earnaud/KOSMOS_test/docs/index.rst

Guide d'assemblage
==========

Cette œuvre est mise à disposition selon les termes de la `Licence
Creative Commons Attribution - Pas d’Utilisation Commerciale - Partage
dans les Mêmes Conditions 4.0
International. <https://creativecommons.org/licenses/by-nc-sa/4.0/>`__
L’auteur à mentionner est Konk Ar Lab et Ifremer

Le KOSMOS est un système pensé collectivement pour prendre la suite des
STAVIRO et MICADO. Deux systèmes développées par Ifremer pour
l’évaluation de l’état des habitats côtiers comme le dénombrement des
éspéces de poissons. Ce système a fait l’objet d’une publication dans la
revue sensors. `Cliquez sur ce lien pour consulter l’article en libre
accès. <https://www.mdpi.com/1424-8220/21/22/7724>`__

Depuis 2011, ces systèmes ont été perfectionnés et une méthodologie
complète qui va de la collecte au traitement des images a été mise au
point (Pelletier et al., 2016). Cette technique est déjà adoptée par le
Parc Naturel Marin de Mayotte, et pourrait convenir aux besoins de suivi
et d’évaluation de la Directive Cadre sur le Milieu Marin qui impose
d’évaluer le bon état écologique des mers européennes, ainsi qu’aux
besoins d’autres Aires Marines Protégées.

Ifremer s’est donc tourné vers le FabLab de Concarneau en sa qualité de
lieu de facilitation sociale par le numérique. Konk Ar Lab, implanté sur
le territoire de Concarneau Cornouaille Agglomération (CCA), il fait
figure depuis presque trois ans d’un lieu de choix réunissant tout type
de publics locaux autour de projets numériques et techniques venus de
divers horizons. C’est dans l’axe Océan du FabLab, que vient se placer
le projet proposé par Ifremer. Il deviendra alors un moyen innovant
d’aborder l’océan et faire connaître ses métiers auprès du public, du
territoire.

Ainsi Ifremer s’est associé au FabLab, pour concevoir un système inspiré
du STAVIRO et du MICADO avec la volonté de l’ouvrir à tous en
documentant sa conception. Ce projet technique sera donc un support pour
l’oeuvre sociale que mène le FabLab. A plus long terme, et ce avec
probablement le fonds Explore1 et le Marinarium2 de Concarneau, le
système pourrait alimenter un nouveau programme de sciences
participatives afin d’élargir l’audience de la sensibilisation à
l’environnement par la contribution directe du grand-public à la
recherche océanographique.

A/ Matériel nécessaire
----------------------

-  Imprimante 3D (plateau 20*20 minimum)
-  Fer à souder
-  Ecran avec connecteur HDMI
-  Souris USB
-  Clavier
-  Pince à sertir les connecteurs dupont
-  Troisième main
-  Gaine thermorétractable
-  Fil d’étain
-  Tourne vis
-  clés plates
-  Mini-perceuse-fraiseuse Dremel avec ses mini-fraises
-  Scotch papier (Protection des circuits électroniques pendant fraisage
   des trous de la PiCam)
-  Chargeur de baterrie lipo 3s
-  Câble HDMi - micro HDMi
-  Alimentation secteur Raspberry pi 4 (Usb C)
-  Coupe tube
-  scie à méteaux
-  pied à coulisse
-  réglet
-  `Pro-tronik Prog
   ; <https://www.absolu-modelisme.com/pro-tronik-03878035-bf32-usb-prog.html?___SID=U>`__

B/ Fournitures nécessaires
--------------------------

**Par KOSMOS 3.0**

-  `1 Raspberry Pi 4 modèle B 2Go de ram
   minimum <https://www.kubii.fr/cartes-raspberry-pi/2771-nouveau-raspberry-pi-4-modele-b-2gb-0765756931175.html>`__
   ;
-  `1 Carte Micro SD avec son adaptateur SD vitesse d’encodage 10 et
   capacité 32Go minimum
   ; <https://www.kubii.fr/carte-sd-et-stockage/1819-carte-microsd-kingston-32gb.html?search_query=sd&results=116>`__
-  `1 Clé USB à très faible encombrement
   ; <https://fr.rs-online.com/web/p/cles-usb/7869326>`__
-  `1 Pi camera HQ
   ; <https://www.kubii.fr/cameras-capteurs/2950-camera-hq-officielle-633696492738.html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>`__
-  1 `Objectif Aico 4mm de
   focale <https://aico-lens.com/product/manual-iris-4-0mm-2mp-f2-c-mount-industrial-lens-ach0420mm/>`__
   ;
-  `1 Batterie Li-Po 3s (3 cellules, 2200 mAh) de dimensions maximales
   35X25X115 (en mm)
   ; <https://www.absolu-modelisme.com/accu-lipo-3s-11-1v-2200mah-45c-xt60.html?___SID=U>`__
-  `1 Contrôleur de moteur Brushless ESC 25A pour batterie 3S avec BEC à
   5v et 2A minimum
   ; <https://www.absolu-modelisme.com/pro-tronik-esc-bf30a-bec-3a.html?___SID=U>`__
-  `1 Moteur Brushless immergeable (F 2838 ou équivalent Blue Robotics)
   ; <https://www.amazon.fr/Dilwe-Moteur-imperm%C3%A9able-Brushless-Outrunner/dp/B07PFJD1MQ>`__
-  `2 Bobines de 750g de filament PETG
   ; <https://www.arianeplast.com/218-3d-filament-petg>`__
-  1 Kit de connecteurs dupont ;
-  `4 Résistances 1 Kohm
   ; <https://fr.rs-online.com/web/p/resistances-traversantes/4777928>`__
-  `2 Résistances 220 ohm
   ; <https://fr.rs-online.com/web/p/resistances-traversantes/7397405>`__
-  `1 LED verte ; <https://fr.rs-online.com/web/p/led/0826436>`__
-  `1 LED rouge ; <https://fr.rs-online.com/web/p/led/2285988>`__
-  `2 ILS (Interrupteur à lame souple)
   ; <https://fr.rs-online.com/web/p/interrupteurs-reed/1718465>`__
-  `1 Rallonge de câble de charge batterie 3s
   ; <https://www.absolu-modelisme.com/rallonge-lipo-30cm-22awg-jst-hx-3s.html?___SID=U>`__
-  Colsons fins (2mm) de longueur 160 mm ;
-  Graisse silicone (matériel de plongée) ;
-  `1 Carte de prototypage en ligne
   ; <https://fr.rs-online.com/web/p/cartes-a-bandes/1004328>`__
-  `1 Connecteur XT60 male
   ; <https://www.absolu-modelisme.com/prise-xt60-male.html?___SID=U>`__
-  `1 Boite d’entretoise laiton
   M2,5 <https://www.amazon.fr/gp/product/B07MN2GY6Y/ref=ppx_yo_dt_b_asin_title_o01_s00?ie=UTF8&psc=1>`__
-  `1 Boite de visserie Inox
   M2,5 <https://www.amazon.fr/gp/product/B07RBTGT7B/ref=ppx_yo_dt_b_asin_title_o01_s00?ie=UTF8&psc=1>`__

Visserie Inox A4

-  8 Vis M3 20mm (pour la fixation de la Raspberry et de la Pi camera)
-  120 Ecrous M3
-  Tige filetée M8 (120mm)

Matériel `Blue Robotics <https://bluerobotics.com/>`__

-  `1 Tube acrylique 298 mm (4" series
   ) <https://boutique.rov-expert.fr/blue-robotics/28-19-tube-acrylique.html#/16-declinaison-4_298mm>`__
   ;
-  1 Pompe à vide manuelle
-  `1 Capteur de pression Bar 30
   ; <https://boutique.rov-expert.fr/blue-robotics/8-bar30-capteur-de-pression-haute-resolution-300m.html>`__
-  `1 Bouton de commande étanche
   ; <https://boutique.rov-expert.fr/blue-robotics/101-Interrupteur.html>`__
-  `1 Tape (End cap) Aluminium 5 trous (4" series)
   ; <https://boutique.rov-expert.fr/blue-robotics/4-6-tape-aluminium.html#/6-declinaison-5_trous_4_>`__
-  `1 Tape (End cap) Acrylique (4"series)
   ; <https://boutique.rov-expert.fr/blue-robotics/30-22-tape-acrylique-transparente.html#/1-declinaison-serie_3_>`__
-  `1 Bouchon de purge (Vent)
   ; <https://boutique.rov-expert.fr/blue-robotics/38-aeration-et-bouchon.html>`__
-  `2 connecteurs 3 broches cobalt
   ; <https://boutique.rov-expert.fr/blue-trail-engineering/140-132-connecteur-de-cloison-cobalt-m10.html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>`__
-  `2 câbles 3 broches cobalt
   ; <https://boutique.rov-expert.fr/blue-trail-engineering/141-136-connecteur-cobalt.html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>`__
-  Résine pour pénétrateur ;

1/ Impression des pièces en 3D
------------------------------

Imprimer toutes les pièces nécessaires. `Les fichiers STL sont
disponibles
ici <https://wikifactory.com/@konkarlab/kosmos30/files/KOSMOS_3-0_beta1/3Dmodels_KOSMOS_3-0>`__
.

**1.1 Pour l’intérieur du caisson :**

-  1 x I1 qui va supporter la carte Rapsberry
-  1x I2, qui va faire le lien entre la structure Raspberry et la plaque
   sur laquelle va se positionner les batteries.
-  1x I3,qui va supporter la PiCam
-  1x I4, qui va se visser à une flange du tube pour empécher les
   structures internes du KOSMOS de pouvoir tourner dans le tube.

`View inte3D_legende.png @
Wikifactory <https://wikifactory.com/@konkarlab/kosmos30/file/pictures_assembly_process/Captions/inte3D_legende.png>`__

**1.2 Pour l’extérieur du caisson :**

Toutes ces pièces doivent êtres impérativement imprimés en PET. En
effet, cette matière est la plus résistante à l’eau de mer parmi les
matériaux disponibles en impression 3D FDM. Si vous disposez d’autres
technologies, ne pas hésiter à essayer et nous faire part du résultat.
Cependant, nous savons que la résine par SLA ne convient pas pour une
raison de dureté. Il peut-être intéressant également de travailler à un
réducteur sans impression 3D à la fraiseuse uniquement pour rendre la
plongée possible à de plus grandes profondeurs.

Nous recommandons un taux de remplissage des pièces qui ne soit
inférieur à 30%. Toutes nos pièces ont un taux de remplissage à 100%.

-  1x R3 qui permet de transmettre l’effort de la croix de malte à la
   tige fileté.
-  1x R5, permets de guider l’arbre secondaire et de ne pas serrer les
   flasques avec les engrenages de cet arbre.
-  1x R6, une entretoise sur l’arbre primaire
-  1x R4, l’entretoise pour le support moteur
-  1x Reducteur3D n°5 SupMag, permets de placer le capteur magnétique
-  2x R1 et 2x R1.2 , permet de maintenir le caisson solidaire au

`View PHOTO_20220317_182010_petit.png @
Wikifactory <https://wikifactory.com/@konkarlab/kosmos30/file/pictures_assembly_process/Captions/PHOTO_20220317_182010_petit.png>`__

*Note : Toutes les pièces devront être netoyées de leurs supports et au
cours du montage, elles nécéssiteront peut-être d’être limées (papier de
verre ou lime à main) afin de supprimer toutes traces de fils d’anges.*

2/ Découpe des pièces planes au laser
-------------------------------------

Le KOSMOS 2.3 est composé en plus de pièces imprimés en 3D et de
visserie Inox de pièces à découper au laser dans des plaques de PMMA et
de POM. Ainsi on peut immerger ses pièces dans l’eau sans craindre la
pression. Les pièces de l’intérieur du caisson peuvent être aussi
imprimés en 3D. `Les trois fichiers vectoriels évoqués ci-dessous sont
disponibles
ici. <https://wikifactory.com/@konkarlab/kosmos30/files/KOSMOS_3-0_beta1/Laser-cuts_KOSMOS_3-0_beta1>`__

**2.1 Pour l’intérieur du caisson :**

-  Télécharger le fichier PMMA-5mm_A5_laser-cut.svg
-  Découper les pièces S1 S2 dans du PMMA de 5mm d’éppaisseur (prévoir
   l’équivalent de la surface d’une feuille A5) ;

`View legende_str_int_PMMA_5mm_A5.png @
Wikifactory <https://wikifactory.com/@konkarlab/kosmos30/file/pictures_assembly_process/Captions/legende_str_int_PMMA_5mm_A5.png>`__

**2.2 Pour l’extérieur du caisson :**

Ces pièces constituent l’enveloppe du réducteur du KOSMOS. On peut les
réaliser en PMMA 5mm si on veut voir à travers ou un autre plastique de
5mm comme des plaques de plastique recyclé.

-  Il est nécéssaire de sélectionner une plaque de PMMA bien plane de
   5mm d’épaisseur (prévoir l’équivalent de la surface d’une feuille A3)
   ;
-  Télécharger le fichier PMMA-5mm_A3_Laser-cut.svg pour lancer une
   découpe au laser ou à la fraiseuse numérique ;
-  Toutes les pièces sont disposées ici de manière à rentrer dans un
   format A3 (42*29,7 cm).

`View legende_decoupePMMAA3.png @
Wikifactory <https://wikifactory.com/@konkarlab/kosmos30/file/pictures_assembly_process/Captions/legende_decoupePMMAA3.png>`__

**2.3 Les pièces en mouvements (engrenages…) seront usinés de préférence
en POM.**

-  Il est nécéssaire de sélectionner une plaque de POM bien plane de 5mm
   d’épaisseur ;
-  Utiliser le fichier POM-5mm_A4_laser-cut.svg pour lancer une découpe
   ;
-  Toutes les pièces sont disposées ici de manière à rentrer dans un
   format A4 (21*29,7 cm) ;

`View legende_decoupePOMA4.png @
Wikifactory <https://wikifactory.com/@konkarlab/kosmos30/file/pictures_assembly_process/Captions/legende_decoupePOMA4.png>`__

3/ Assemblage des composants intérieurs au caisson
--------------------------------------------------

3.1 **Assemblage de la caméra :**

-  Rassembler, la Picam HQ, sa nappe (câble plat), la stucture caméra
   n°3, 3 vis M2,5*5mm, 4 entretoises en laiton M2,5*5+5mm et 4
   rondelles M2,5.



   image

-  A l’aide d’une pince plate, visser les 4 entretoises en laiton dans
   les trous prévus à cet effet dans la structure de la caméra n°3.



   image

-  Puis, à l’aide d’une clé alen de 2mm, visser la caméra sur ses 4
   entretoises à l’aides des 4 vis M2,5 et 4 rondelles. La caméra doit
   être positionné comme présenté sur la photo ci dessous. La sortie de
   la nappe du coté opposé aux fixations.



   image

**3.2 Assemblage de la Raspberry :**

-  Rassembler, le support de la Raspberry, structure n°6, la Raspberry
   Pi 4 modèle B, 4 entretoises en laiton M2,5*10, 4 vis M2,5 6mm et 4
   rondelles M2,5.



   image

-  A l’aide d’une pince plate, visser les 4 entretoises sur les trous
   R1, R2, R3 et R4 (cf photo ci dessous).



   image

-  Enfin, à l’aide d’une clé alen 2mm, visser la raspberry sur son
   support (cf photo ci-dessous). Veiller au sens, l’encode de la
   structure 6 doit être en face de l’emplacement de la carte SD de la
   Raspberry.



   image

**3.3 Assembler le circuit d’alimentation :**

-  Rassembler, le circuit d’alimentation (cf etape Câblage), la
   Raspberry sur son support, 2 entretoises laiton de 5mm, 2 vis M3*5mm,
   2 vis M2,5*5mm et 2 rondelles.



   image

-  A l’aide d’une pince plate, visser les deux entretoises sur deux
   trous diagonalement opposés au dos de la Raspberry sur le pièce en
   PMMA. (Si vous possédez plus d’entretoise que nous, n’hésitez pas à
   en disposer 4).
-  Visser avec les deux vis M3 le transformateur 12 to 5v et le relai
   sur les entretoises à l’aide des vis M2,5.



   image

-  Passer le câble avec le connecteur USB-C par l’encoche de la
   structure n°6 de manière à pouvoir le brancher sur le port
   d’alimentation de la Raspberry. Positionner l’ESC sur le dessus du
   transformateur au moyen d’un scotdh double face. Maintenez les câbles
   à l’aide de colsons.



   image

**3.4 Finalisation de l’assemblage interne :**

-  Rassembler la Raspberry et son support (Str n°6), la caméra et sa
   structue n°3, la structure n°1, N°2 et n°5, 8 ecrous M3, 6 vis
   M3*10mm, et 2 vis M3*15mm, 2 vis M4*30mm, 2 écrous M4.



   image

-  Insérer 4 écrous M3 dans les fentes prévus à cet éffet sur la
   structure n°1 (cf photo ci dessous)



   image

-  Visser la carte Raspberry pi 4 et sonsupport (Str n°6) sur le
   structure n°1 à l’aide de deux vis M3*15mm en haut et deux vis
   M3*10mm en bas. Attention au sens de la Raspberry (cf photo
   ci-dessous).



   image

-  Brancher le connecteur USB-C sur le port d’alimentation de la
   raspberry. Veiller à bien couder la câble afin qu’il ne gène pas à
   l’avenir l’insertion dans le tube.



   image

-  Insérer 2 écrous sur la structure batterie (n°2) et 2 autres sur la
   structure caméra (n°3).
-  Visser la plaque en PMMA (Str n°5) à l’aide de 2 vis M3*10mm sur la
   structure batterie (n°2).



   image

-  Visser l’autre extrémité de la plaque de PMMA (Str n°5) sur la
   structure caméra (n°3).



   image

-  Assembler les deux partie composé l’une de la raspberry et de sa
   structure et de l’autre le support de la batterie et de la caméra.
   Veiller à passer les câbles au travers des pièces et à ne pas les
   abimer.
-  Visser ces deux parties au moyen de deux vis M4*30mm et de deux
   écrous M4. Serrer de manière à ce que la tête de vis ne puisse géner
   l’insertion du KOSMOS dans le Tube.



   image

-  Brancher la nappe de la PiCam à la carte Raspberry. La carte porte
   une inscription “CAMERA” au dessus de ce connecteur , il est à
   proximité des connecteurs USB. Pour la connexion, lever (sans ôter)
   la partie grise du connecteur et placer le côté bleu de l’’extrémité
   de la nappe face aux connecteurs USB. Refermer la pièce de serrage
   grise. (cf photos ci dessous)



   image

**3.5 Installation de la Batterie**

-  Rassembler la partie interne du KOSMOS, une batterie lipo 3s 2200mAh
   une rallonge de câble de recharge Lipo 3s et 2 colsons.



   image

-  Positionner la batterie sur son support sur un des deux flancs.
   Maintenir en place la batterie à l’aide de colsons.



   image

-  Brancher le connecteur XT60 avec celui du circuit d’alimentation.
-  Brancher la rallonge de rechargement au connecteur de la batterie. Ce
   câble circulera vers l’arrière en passant devant la Raspberry.



   image

4/ Assemblage du caisson
------------------------

Pour l’assemblage du tube, il sera nécessaire de graisser (graisse
silicone de plongée) certaines pièces pour à la fois assurer
l’étanchéité et faciliter le démontage du tube étanche. Attention, il ne
faut graisser que les pièces qui coulissent (ex : Flange, bouchons,
interrupteurs rotatifs). Le graissage se fait au doigt et consiste à
simplement huiler les surfaces qui doivent coulisser ou tourner tout en
restant étanche.

**4.1 Assemblage du bouton rotatif :**

-  Le bouton rotatif est livré démonté par Blue robotics. Rassembler le
   passe-coque, le bouton, les trois joints thoriques, le poussoir, les
   deux fils et l’écrou.

`View DSC_0142.JPG @
Wikifactory <https://wikifactory.com/@konkarlab/kosmos30/file/pictures_assembly_process/Camera_case/DSC_0142.JPG>`__

-  Placer le plus grand des trois joint thorique dans la gorge du
   passe-coque.

`View DSC_0147.JPG @
Wikifactory <https://wikifactory.com/@konkarlab/kosmos30/file/pictures_assembly_process/Camera_case/DSC_0147.JPG>`__

-  Au doigt, graisser les deux joints restants. Puis insérer les dans
   les deux gorges du bouton noir.

`View DSC_0149.JPG @
Wikifactory <https://wikifactory.com/@konkarlab/kosmos30/file/pictures_assembly_process/Camera_case/DSC_0149.JPG>`__

-  Visser le bouton noir dans le passe-coque. Le vissage doit être
   facile. Si ce n’est pas le cas, il sera peut-être nécéssaire de
   graisser d’avantage.

`View DSC_0150.JPG @
Wikifactory <https://wikifactory.com/@konkarlab/kosmos30/file/pictures_assembly_process/Camera_case/DSC_0150.JPG>`__

-  Visser l’écrou sur le passe-coque.

`View DSC_0153.JPG @
Wikifactory <https://wikifactory.com/@konkarlab/kosmos30/file/pictures_assembly_process/Camera_case/DSC_0153.JPG>`__

-  A l’extrémité opposé au bouton noir, visser le bouton poussoir.
   Dévisser légèrement le bouton noir de manière à ce que le poussoir
   soit ouvert (surveiller à l’aide d’un multimètre sur le mode
   continuité).
-  Pour finir connecter les fils sur les broches du bouton poussoir.

`View DSC_0163.JPG @
Wikifactory <https://wikifactory.com/@konkarlab/kosmos30/file/pictures_assembly_process/Camera_case/DSC_0163.JPG>`__

**4.2 Assemblage du bouchon vent :**

-  Le bouchon vent est livré démonté par Blue robotics. Rassemblez le
   passe-coque, le bouchon, les trois joints thoriques, le poussoir, les
   deux fils et l’écrou.

`View DSC_0164.JPG @
Wikifactory <https://wikifactory.com/@konkarlab/kosmos30/file/pictures_assembly_process/Camera_case/DSC_0164.JPG>`__

-  Placer le plus grand des trois joint thorique dans la gorge du
   passe-coque. Puis visser l’écrou.

`View DSC_0165.JPG @
Wikifactory <https://wikifactory.com/@konkarlab/kosmos30/file/pictures_assembly_process/Camera_case/DSC_0165.JPG>`__

-  Insérer les deux petits joints thoriques dans les deux gorges du
   bouchon.

`View DSC_0166.JPG @
Wikifactory <https://wikifactory.com/@konkarlab/kosmos30/file/pictures_assembly_process/Camera_case/DSC_0166.JPG>`__

-  Visser le bouchon sur le passe-coque.

`View DSC_0167.JPG @
Wikifactory <https://wikifactory.com/@konkarlab/kosmos30/file/pictures_assembly_process/Camera_case/DSC_0167.JPG>`__

**4.3 Assemblage du capteur de pression**

-  Le capteur de pression est livré démonté par Blue robotics.
   Rassembler le capteur dans son passe-coque, le joint thorique et
   l’écrou.

`View DSC_0168.JPG @
Wikifactory <https://wikifactory.com/@konkarlab/kosmos30/file/pictures_assembly_process/Camera_case/DSC_0168.JPG>`__

-  Insérer le joint thorique dans la gorge et engager l’écrou sur le
   capteur.

`View DSC_0170.JPG @
Wikifactory <https://wikifactory.com/@konkarlab/kosmos30/file/pictures_assembly_process/Camera_case/DSC_0170.JPG>`__

**4.4 Serrage des passes-coques sur le end cap aluminium**

-  Rassembler, le end cap en aluminium à 5 trous, les deux connecteurs
   cobalts femelles, ainsi que les trois passes-coques précédamment
   assemblés (bouton rotatif, bouchon vent, et capteur de pression).

`View DSC_0175.JPG @
Wikifactory <https://wikifactory.com/@konkarlab/kosmos30/file/pictures_assembly_process/Camera_case/DSC_0175.JPG>`__

-  Visser les des connecteurs cobalt sur deux trous voisins. Attention à
   veiller à positionner le joint du côté externe.

`View DSC_0179.JPG @
Wikifactory <https://wikifactory.com/@konkarlab/kosmos30/file/pictures_assembly_process/Camera_case/DSC_0179.JPG>`__

-  Visser et serrer les 3 autres passe-coques. Serrer fort les 5
   passes-coques.

`View DSC_0216.JPG @
Wikifactory <https://wikifactory.com/@konkarlab/kosmos30/file/pictures_assembly_process/Camera_case/DSC_0216.JPG>`__

**4.5 Assemblage du end-cap sur la flange**

-  Rassembler, le end-cap et ses passes-coques, une flange ainsi que les
   pièces fournies avec la flange (3 joints thoriques, et un 6 vis M3).

`View DSC_0222.JPG @
Wikifactory <https://wikifactory.com/@konkarlab/kosmos30/file/pictures_assembly_process/Camera_case/DSC_0222.JPG>`__

-  Au doigts graisser légèrement les deux joints les plus épais.
-  Insérer ses derniers dans les gorges prévues à cet effet.

`View DSC_0172.JPG @
Wikifactory <https://wikifactory.com/@konkarlab/kosmos30/file/pictures_assembly_process/Camera_case/DSC_0172.JPG>`__

-  Insérer sans graisser le plus fin des joint thorique dans la dernière
   gorge de la flange.

`View DSC_0173.JPG @
Wikifactory <https://wikifactory.com/@konkarlab/kosmos30/file/pictures_assembly_process/Camera_case/DSC_0173.JPG>`__

-  Visser le end-cap sur la flange à l’aide des 6 vis M3.

`View DSC_0229.JPG @
Wikifactory <https://wikifactory.com/@konkarlab/kosmos30/file/pictures_assembly_process/Camera_case/DSC_0229.JPG>`__

**4.6 Assemblage du bouchon hublot**

-  Rassembler la seconde flange, ses 3 joints thoriques, le hublot
   (end-cap clear) et les 6 vis M3.

`View DSC_0232.JPG @
Wikifactory <https://wikifactory.com/@konkarlab/kosmos30/file/pictures_assembly_process/Camera_case/DSC_0232.JPG>`__

-  Exactemment comme à l’étape précédente installer les 3 joints sur la
   seconde flange. Ne pas oublier le graissage des deux gros joints.
-  Visser le hublot à l’aide des 6 vis M3.

`View DSC_0233.JPG @
Wikifactory <https://wikifactory.com/@konkarlab/kosmos30/file/pictures_assembly_process/Camera_case/DSC_0233.JPG>`__

**4.7 Assemblage du détrompeur**

Le détrompeur est une pièce bleu permettant d’inssérer la caméra dans un
sens défini dans le tube. Il est imprimé en 3D et se vis sur le bouchon
hublot du caisson.

-  Rassembler le bouchon hublot, le détrompeur (I4), et 4 vis M3*20mm.

`View DSC_0234.JPG @
Wikifactory <https://wikifactory.com/@konkarlab/kosmos30/file/pictures_assembly_process/Camera_case/DSC_0234.JPG>`__

-  Visser le détrompeur sur l’arrière du bouchon hublot.

`View DSC_0235.JPG @
Wikifactory <https://wikifactory.com/@konkarlab/kosmos30/file/pictures_assembly_process/Camera_case/DSC_0235.JPG>`__

**4.7 Assemblage final du tube**

-  Rassembler les deux bouchons et le tube acrylique.

`View DSC_0238.JPG @
Wikifactory <https://wikifactory.com/@konkarlab/kosmos30/file/pictures_assembly_process/Camera_case/DSC_0238.JPG>`__

-  Dévisser totalement le bouchon du vent (OK) pour faire un appel
   d’air.
-  Insérer chaque bouchon à une extrémité du tube. Il doivent s’insérer
   facilement (dans le cas contraire ajouter de la graisse.
-  Refermer le bouchon du vent.

`View DSC_0239.JPG @
Wikifactory <https://wikifactory.com/@konkarlab/kosmos30/file/pictures_assembly_process/Camera_case/DSC_0239.JPG>`__

-  Pour ouvrir le caisson dans les étapes suivantes, commencer par
   ouvrir le vent, puis tirer bien dans l’axe le bouchon des
   passes-coques. Il n’est pas nécéssaire de regresser à chaque fois.
   Cependant il faudra veiller à ne pas salir les parties graissées.

5/ Electroniques et câblages
----------------------------

**5.1 Perçage du PCB et soudure**

-  A l’aide d’une dremel sur colonne ou d’une dremel à la main percer
   les trous du circuit imprimé avec un foret de 0,8mm.
-  Élargir les trous dans lesquelles on soudera des pins duponts males
   (Encadrés en vert cf. visuels ci dessous) à l’aide d’un foret de
   0,9mm ou 1mm.
-  A ces mêmes emplacements, souder des broches duponts mâles.
   /! Attention on soude les composants de manière a ce qu’ils soient
   sur la face opposé au circuit. Seule les pattes traversent et sont
   soudés du coté du circuit.

`View PCB_step3-1.png @
Wikifactory <https://wikifactory.com/@konkarlab/kosmos30/file/pictures_assembly_process/PCB/PCB_step3-1.png>`__

-  Souder 2 résistances de 220ohm et 6 résistances de 1Kohm (cf. photo
   ci dessous, 220ohm en bleu et 1kohm en orange). (PCB_step3-2.png).

`View PCB_step3-2.png @
Wikifactory <https://wikifactory.com/@konkarlab/kosmos30/file/pictures_assembly_process/PCB/PCB_step3-2.png>`__

-  Souder les deux diodes en veillant à respecter la polarité. Sur une
   diode le plus est matérialisé par la patte la plus longue. (Une LED
   rouge et une LED verte cf.photo ci dessous).

`View PCB_step3-3.png @
Wikifactory <https://wikifactory.com/@konkarlab/kosmos30/file/pictures_assembly_process/PCB/PCB_step3-3.png>`__

-  Souder 4 fils qui servirons de pont (en vert cf. dessin ci dessous).

`View PCB_step3-4.png @
Wikifactory <https://wikifactory.com/@konkarlab/kosmos30/file/pictures_assembly_process/PCB/PCB_step3-4.png>`__

-  Souder sur les broches duponts, dans le sens indiqué les 3 modules
   RTC (Horloge), l’indicateur de niveau de batterie et le relai.

`View PCB_step3-5.png @
Wikifactory <https://wikifactory.com/@konkarlab/kosmos30/file/pictures_assembly_process/PCB/PCB_step3-5.png>`__

-  Souder 3 ILS sur les emplacements indiqués (en orange cf. dessin ci
   dessous). (PCB_step3-6.png)

`View PCB_step3-6.png @
Wikifactory <https://wikifactory.com/@konkarlab/kosmos30/file/pictures_assembly_process/PCB/PCB_step3-6.png>`__

Paramétrer la Raspberry
-----------------------

La raspberry pi 4 n’est autre que le cerveau du KOSMOS. Pour configurer
la raspberry, il faudra brancher la raspberry à un écran, et connecter
par les USB un clavier et une souris. On peut aussi alimenter la carte
par son alimentation 220v plutôt que d’utiliser la batterie.

Si votre carte SD ne contient pas le système d’exploitation raspbian, il
faudra l’installer pour cela l\ `es tutoriels extérieurs sont
efficaces. <https://raspberry-pi.fr/creer-carte-sd-windows-mac-linux-raspberry-pi-imager/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,base%20Debian%2C%20par%20exemple%20Ubuntu>`__

-  Une fois l’OS de la raspberry installé, connecter cette dernière au
   wifi.
-  Ouvrir un terminal de commande en pressant (ctrl + alt +t)
-  Lancer une mise à jour par les commandes suivantes (pour lancer une
   commande, ecrire son contenu sans en changer ni la forme ni
   l’orthographe et taper sur entrer. Attendre que la ligne commançant
   par le $ revienne avant de lancer la seconde).

   -  ``sudo apt update``
   -  Puis ``sudo apt upgrade``

-  Puis lancer commande ``sudo raspi-config``. Cette commande va ouvrir
   un menu dans lequel on ne peut se déplacer qu’avec le clavier.

   -  activer la caméra
   -  activer l’I2C
   -  activer le serial port

-  Puis sortir de raspi config
-  Redémarrer la raspberry
-  Installer désormais des librairies avec les commandes suivantes sur
   le terminal

   -  Python smbus ``sudo apt install python-Smbus``
   -  ``wget``\ https://github.com/joan2937/pigpio/archive/master.zip\`\ ````\ unzip
      master.zip\ ````\ cd pigpio-master\ ````\ make\ ````\ sudo make
      install\` Cela permets d’installer la librairie pour commander le
      moteur

-  Enfin toujours sur le terminal de commande, après avoir branché la
   clé USB sur un port USB3 (bleu), attribuer tous les droits
   d’exécution à la clé.

   -  Pour cela rendez-vous dans le dossier contenant la clé
      ``cd /media/pi``
   -  Une fois ici on peut lancer la commende ``ls -l`` qui permets de
      lister les fichiers présents dans le dossier.
   -  Retrouver la clé USB par son nom.
   -  Puis attribuer les droits d’exécution à cette clé
      ``sudo chmod a+x LeNomdeLaCle``

-  **A compléter pour le GPS ou RTC**

Calibrer l’ESC
--------------

-  A l’aide de la clé USB pro-Tronik PROG, brancher la prise BEC sur le
   PC. (Veiller au sens de la prise BEC sur le port du connecteur.
-  Télécharger le logicile BHeli correspondant à votre OS :
   https://drive.google.com/drive/folders/1Y1bUMnRRolmMD_lezL0FYd3aMBrNzCig
-  Une fois téléchargé, décomprésser et ouvrir le programme.
-  En bas, de la fenêtre qui s’ouvre, sélectionner le bon port com.
-  Puis choisir la vitesse de communication 19200.
-  Appuyer sur “connect”
-  Si cela ne fonctionne pas dans les menu en haut cliquer sur “Select
   BLHeli_32 interface” et séléctionner “(USB/com)” Puis essayer à
   nouveau la connexion.
-  Brancher la batterie à l’ESC.

Assemblage du réducteur
-----------------------

Le KOSMOS est une caméra sous-marine capable de pivoter dans un sens
unique par pas de 60°. Ainsi elle observera un panoramique en
sous-échantillonant par 6 plans vidéos de 60° et 30s chacun.

La question de la motorisation à longuement posé problème. Par soucis de
reproductibilité (outillage standart d’un Fab Lab), nous avons vite
écarté la possibilité de réaliser une transmission mécanique par arbre
traverssant. Nous avons donc du trouver un autre moyen. Nous sommes donc
partis d’un moteur de ROV capable de tourner dans l’eau. Seulement il
s’agit d’un moteur Brushless qui donc tourne vite et déploi peu de
couple.

Afin de réduire la vitesse et augmenter le couple d’entrainement, nous
avons donc décidés d’utiliser un réducteur à 4 étages. La dernière roue
entraine un bras qui fait tourner une croix de Malte. Cette dernière
permets de réaliser un angle de 60° précisément lorsque la dernière roue
effectue un tours complet. Afin de valider la position des engrenages.
Nous avons ajoutés un capteur magnétique (contact reed).

**Préparation des engrenages**

-  Préparer les pièces pour monter les 3 premiers pignons. Pour cela,
   rassemblez les P2 , P3 et P3.2, et 9 vis M2,5 \* 12mm.

`View DSC_0017_petit.jpg @
Wikifactory <https://wikifactory.com/@konkarlab/kosmos30/file/pictures_assembly_process/Reducer/DSC_0017_petit.jpg>`__

-  A l’aide d’un foret à métaux de 4mm et d’une perceuse (à colonne de
   préférence), élargir les 3 trous des trois pignons n°1 sur une
   profondeur permettant à la tête de vis de ne pas dépasser.
-  A l’aide d’une clé alen de 2mm, assembler les trois trio de pignons
   comme présenté ci-dessous. On place un pignon P3.2 entre un P2 et un
   P3. La vis viendra tarauder le pignon P3. Avant de serrer veillez à
   bien aligner la denture entre les pignons P3 et P3.2.

**Assembler la croix de Malte**

-  Rassembler la croix de malte P4, une rondelle inox M8*22mm, 4 vis
   M3*18mm et la pièce R3.

`View DSC_0043.JPG @
Wikifactory <https://wikifactory.com/@konkarlab/kosmos30/file/pictures_assembly_process/Reducer/DSC_0043.JPG>`__

-  Assembler la croix de Malte en insérant la rondelle dans
   l’emplacement prévu à cet effet, entre la croix de Malte et la pièce
   R3. Visser avec les 4 vis à l’aide d’une clé alen de 2,5mm.

`View DSC_0216.JPG @
Wikifactory <https://wikifactory.com/@konkarlab/kosmos30/file/pictures_assembly_process/Reducer/DSC_0216.JPG>`__

**Découpe des entretoises et tiges filetés :**

-  Couper 4 morceaux de tube inox à des longueurs différentes (1*42,5mm
   ; 1\* 49,2mm et 2\* 51,3mm). On peut effectuer une première coupe au
   coupe tube puis finir au tour à métal. Veiller à bien ébarber les
   extrémités afin que la tige fileté s’incère facilement à l’intérieur
   du tube ;

-  A l’aide d’une meuleuse ou à la scie à méteaux, couper 4 morceaux de
   tige filetée inox M8 de 1*160mm et 3*85mm de longueur. A l’aide d’une
   lime on s’assurera de redresser le filet afin qu’un écrou puisse se
   visser sans difficulté.

**Assemblage de l’arbre primaire :**

-  Rassemblerla croix de malte précédamment montée, deux pignons, deux
   rondelles M8_18mm, deux rondelles M10_22mm, 2 écrous freins M8, la
   pièce R5, le morceau de tube d’inox de longueur 42,5mm et de la tige
   fileté M8 de longueur 160mm.

`View DSC_0045.JPG @
Wikifactory <https://wikifactory.com/@konkarlab/kosmos30/file/pictures_assembly_process/Reducer/DSC_0045.JPG>`__

-  Installer le tube dans la croix de malte, cette dernière viendra
   s’épauler sur la rondelle prise dans la croix de malte. Puis insérer
   une rondelle M10 ;

`View DSC_0047.JPG @
Wikifactory <https://wikifactory.com/@konkarlab/kosmos30/file/pictures_assembly_process/Reducer/DSC_0047.JPG>`__

-  Insérer un pignon (petit pignon vers le bas) puis une rondelle M10,
   puis le deuxième pignon (petit pignon vers le bas). L’entretoise doit
   dépasser de moins d’un milimètre.

`View DSC_0049.JPG @
Wikifactory <https://wikifactory.com/@konkarlab/kosmos30/file/pictures_assembly_process/Reducer/DSC_0049.JPG>`__

-  Visser un écrou frein sur la tige fileté à 85mm (Ajouter de l’huile
   sur la tige pour faciliter le vissage). Ajouter une rondelle M8 sur
   le coté opposé au frein de l’écrou.

`View DSC_0050_petit.jpg @
Wikifactory <https://wikifactory.com/@konkarlab/kosmos30/file/pictures_assembly_process/Reducer/DSC_0050_petit.jpg>`__

-  Insérer cette tige fileté à travers l’assemblage précédamment fait.
   L’écrou pré-vissé sera en buté sous la croix de malte séparé d’une
   rondelle M8.

`View DSC_0051.JPG @
Wikifactory <https://wikifactory.com/@konkarlab/kosmos30/file/pictures_assembly_process/Reducer/DSC_0051.JPG>`__

-  A l’opposé de la croix de Malte (au dessus des pignons) insérer une
   rondelle M8.

`View DSC_0052.JPG @
Wikifactory <https://wikifactory.com/@konkarlab/kosmos30/file/pictures_assembly_process/Reducer/DSC_0052.JPG>`__

-  Au dessus de la rondelle insérer la pièce R5.

`View DSC_0053.JPG @
Wikifactory <https://wikifactory.com/@konkarlab/kosmos30/file/pictures_assembly_process/Reducer/DSC_0053.JPG>`__

-  Serrer le tout par un écrou frein que l’on place au dessus du tout.
   Serrer fermement à l’aide de clés plates. On pourra s’aider d’un
   écrou et contre-écrou pour visser correctement les écrous freins.

`View DSC_0057.JPG @
Wikifactory <https://wikifactory.com/@konkarlab/kosmos30/file/pictures_assembly_process/Reducer/DSC_0057.JPG>`__

-  Assurez-vous que les pignons tournent librement. La croix malte doit
   elle rester immobile.

**Assemblage du bras de malte :**

-  Rassembler les pièces 2\* P5.2 , P5 et la P2.2 ainsi que un aiment en
   néodyme carrée, 3 vis M2,5*18mm et une vis M5*20mm à tête fraisée ;

`View DSC_0006_petit_b.jpg @
Wikifactory <https://wikifactory.com/@konkarlab/kosmos30/file/pictures_assembly_process/Reducer/DSC_0006_petit_b.jpg>`__

-  A l’aide d’une perceuse à colonne et d’un foret de 4,5mm, percer la
   P2.2 pour loger la tête des 3 vis M2,5.
-  A l’aide d’un foret de 10mm, percer la pièce P5 sur 2,5mm de
   profondeur pour loger la tête de la vis M5 ;
-  Insérer 3 vis M2,5 dans les trois petits trous de la pièce P2.2.
   Insérer par dessus les deux P5.2 l’une sur l’autre. La tête de chaque
   vis M2,5 doit se loger dans la P2.2 et ne pas dépasser de cette
   dernière ;

`View DSC_0006_petit-3.jpg @
Wikifactory <https://wikifactory.com/@konkarlab/kosmos30/file/pictures_assembly_process/Reducer/DSC_0006_petit-3.jpg>`__

-  Visser par dessus la P5 qui sert de serrage, en veillant à ce que le
   logement de la tête de vis M5 soit à l’extérieur. A la colle chaude
   insérer l’aiment carrée dans son logement. Veiller à ce qu’il ne
   dépasse pas dutout du coté intérieur ;

`View DSC_0006_petit-b.jpg @
Wikifactory <https://wikifactory.com/@konkarlab/kosmos30/file/pictures_assembly_process/Reducer/DSC_0006_petit-b.jpg>`__

-  Rassembler le bras de malte que nous venons d’assembler, une vis à
   tête fraisée M5*16mm et une paille en inox de diamètre 5mm.
-  Couper au coupe tube un bout de paille inox de 9mm de long et veiller
   à ce que la vis M5 s’y insère sans acros ;
-  Visser la vis M5 en insérant entre la P2.2 et la P5 le tube inox 5mm.
   La tête doit se loger dans la pièce P5 et se visse dans la P2.2 ;

`View DSC_0019_petit-b.jpg @
Wikifactory <https://wikifactory.com/@konkarlab/kosmos30/file/pictures_assembly_process/Reducer/DSC_0019_petit-b.jpg>`__

**Assemblage de l’arbre secondaire :**

-  Rassembler, le bras de malte précédamment assemblé, le tube inox
   10mm*49,2mm, une tige filetée M8*85mm, 4 rondelles M8_18mm, 2
   rondelles M10_22mm, 2 écrous freins M8, la pièces R6, F1, F2, le
   dernier pignon et l’abre primaire ;

`View DSC_0023_petit-b.jpg @
Wikifactory <https://wikifactory.com/@konkarlab/kosmos30/file/pictures_assembly_process/Reducer/DSC_0023_petit-b.jpg>`__

-  Positionner l’arbre primaire sur F2 comme présenté ci-dessous.
   L’assemblage qui suis nécéssite de faire jouer les deux arbres pour
   pouvoir enfiler les engrenages correctement ; (Ajouter annotation des
   plaques + photos pas à jour )

`View DSC_0027_petit-b.jpg @
Wikifactory <https://wikifactory.com/@konkarlab/kosmos30/file/pictures_assembly_process/Reducer/DSC_0027_petit-b.jpg>`__

-  Visser un écrou neel stop M8 sur le bout de la tige filetée en
   laissant dépasser quelques milimètres. Insérer une rondelle M8 ;
-  Passer la tige fileté à travers la pièce F2 par le trou indiqué en
   veillant au sens ;

`View DSC_0028_petit-b.jpg @
Wikifactory <https://wikifactory.com/@konkarlab/kosmos30/file/pictures_assembly_process/Reducer/DSC_0028_petit-b.jpg>`__

-  Passer une rondelle M8, l’entretoise inox 10*49,2mm, l’entretoise en
   plastique R6 et enfin une rondelle M10 ; (Ajout d’une étape pour
   détailler l’ajout du tube puis de R6)

`View DSC_0030_petit-b.jpg @
Wikifactory <https://wikifactory.com/@konkarlab/kosmos30/file/pictures_assembly_process/Reducer/DSC_0030_petit-b.jpg>`__

-  Enfiler le pignon (petit pignon vers le haut ) puis une rondelle M10
   ;

`View DSC_0033_petit_b.jpg @
Wikifactory <https://wikifactory.com/@konkarlab/kosmos30/file/pictures_assembly_process/Reducer/DSC_0033_petit_b.jpg>`__

-  Enfiler le bras de Malte (grand engranage vers le bas), et pour finir
   une rondelle M8,

`View DSC_0035_petit_b.jpg @
Wikifactory <https://wikifactory.com/@konkarlab/kosmos30/file/pictures_assembly_process/Reducer/DSC_0035_petit_b.jpg>`__

-  Refermer par la flasque F1 ;

`View DSC_0036_petit_b.jpg @
Wikifactory <https://wikifactory.com/@konkarlab/kosmos30/file/pictures_assembly_process/Reducer/DSC_0036_petit_b.jpg>`__

-  Sur l’arbre secondaire, on ajoute à la sortie une rondelle M8 puis on
   sert généreusement à l’aide de deux clés de 13 les deux écrous de
   l’arbre secondaire de manière à ce que les deux flasques soient
   maitenues en parallèle ;

`View DSC_0038_petit_b.jpg @
Wikifactory <https://wikifactory.com/@konkarlab/kosmos30/file/pictures_assembly_process/Reducer/DSC_0038_petit_b.jpg>`__

-  Surveiller que les deux arbres s’entrainent correctement en tournant
   à la main le gran pignon le plus éloigné de la croix de malte ;

-  Rassembler, les deux tubes inox 10*51,3mm, deux tiges filetées de
   M8*85mm, 2 écrous freins M8 et 2 écrous M8 ;

`View DSC_0048_petit_b.jpg @
Wikifactory <https://wikifactory.com/@konkarlab/kosmos30/file/pictures_assembly_process/Reducer/DSC_0048_petit_b.jpg>`__

-  Visser un écrou frein à l’éxtrémité de chaque tige filetée. Liasser
   la tige fileter dépasser de l’écrou de quelques milimètres ;

`View DSC_0051_petit_b.jpg @
Wikifactory <https://wikifactory.com/@konkarlab/kosmos30/file/pictures_assembly_process/Reducer/DSC_0051_petit_b.jpg>`__

-  Insérer ses tiges à travers la flasque F1, insérer sur chaque tige
   entre les deux flasques un tube inox (entretoise), puis serrer au
   moyen des écrous M8.

`View DSC_0058_petit_b.jpg @
Wikifactory <https://wikifactory.com/@konkarlab/kosmos30/file/pictures_assembly_process/Reducer/DSC_0058_petit_b.jpg>`__

**Fixation du moteur :**

-  Rassembler le moteur auquel on aura otté l’hélice (si livré avec) en
   plastique au moyen d’une dremel, 6 vis M3*8mm, 3 vis M3*40mm, les
   pièces C3, P1 et R4 ;

`View DSC_0074_petit_b.jpg @
Wikifactory <https://wikifactory.com/@konkarlab/kosmos30/file/pictures_assembly_process/Reducer/DSC_0074_petit_b.jpg>`__

-  Visser la plaque C3 sur le moteur (du coté où sortent les fils).
   Attention à verifier qu’en positionnant les fils du moteur dans
   l’encoche de R4, les trous destinés à passer les vis M3*40 s’alignent
   entre C3 et R4 ;

`View DSC_0077_petit_b.jpg @
Wikifactory <https://wikifactory.com/@konkarlab/kosmos30/file/pictures_assembly_process/Reducer/DSC_0077_petit_b.jpg>`__

-  Visser le moteur au réducteur sur F2 avec les vis M3*40mm. Les vis
   traverssent C3 et R4 pour se serrer dans F2 ;

`View DSC_0080_petit_b.jpg @
Wikifactory <https://wikifactory.com/@konkarlab/kosmos30/file/pictures_assembly_process/Reducer/DSC_0080_petit_b.jpg>`__

-  Visser le pignon P1 au bout du moteur au moyen de deux vis M3*8mm ;

`View DSC_0082_petit_b.jpg @
Wikifactory <https://wikifactory.com/@konkarlab/kosmos30/file/pictures_assembly_process/Reducer/DSC_0082_petit_b.jpg>`__

**Installation du capteur magnétique :**

-  Rassembler le capteur magnétique contact reed étanche, la pièce R7,
   une vis M3*18mm, une rondelle M3 et un écrou M3.

`View DSC_0083_petit_b.jpg @
Wikifactory <https://wikifactory.com/@konkarlab/kosmos30/file/pictures_assembly_process/Reducer/DSC_0083_petit_b.jpg>`__

-  Insérer le capteur dans R7 puis visser R7 sur F1 dans le trou oblond.
   Le capteur doit être positionné à l’extérieur du réducteur. On
   avancera le capteur pour qu’il soit au plus près de l’aiment collé
   sur le bras de Malte ;

`View DSC_0084_petit.jpg @
Wikifactory <https://wikifactory.com/@konkarlab/kosmos30/file/pictures_assembly_process/Reducer/DSC_0084_petit.jpg>`__

**Montage des bers (supports du caisson) :**

-  Rassembler les pièces du ber 2*R1 et 2*R1.2. Ainsi que 2 vis M5*30mm,
   2 vis à tête hexagonale M5*20mm et 4 écrous à frein filet M5.

`View DSC_0241_petit.JPG @
Wikifactory <https://wikifactory.com/@konkarlab/kosmos30/file/pictures_assembly_process/Reducer/DSC_0241_petit.JPG>`__

-  Reproduire les étapes qui suivent deux fois.
-  Installer la vis M5*20mm à tête hexagonale de manière à former une
   charnière entre R1 et 1.2. Serrer à l’aide d’un écrou frein juste
   sufissament pour empêcher l’écrou de se désolidariser de la vis sans
   gêner l’ouverture du ber.
-  Installer la vis CHC sur la fermeture du ber. On bloquera à l’aide de
   l’écrou frein M5.

`View DSC_0243.JPG @
Wikifactory <https://wikifactory.com/@konkarlab/kosmos30/file/pictures_assembly_process/Reducer/DSC_0243.JPG>`__

**Installation des Bers sur le réducteur :**

-  Rassembler le réducteur, les deux bers précédemment montées, 4 vis à
   tête fraisée M5*20mm et 4 écrous M5 de préférence à frein filet.

`View DSC_0247.JPG @
Wikifactory <https://wikifactory.com/@konkarlab/kosmos30/file/pictures_assembly_process/Reducer/DSC_0247.JPG>`__

-  A l’aide des vis et des écrous M5, fixer les deux bers sur le dessus
   du réducteur. Veiller à ce que l’ouverture se fasse dans le même sens
   sur les deux bers.

`View DSC_0249.JPG @
Wikifactory <https://wikifactory.com/@konkarlab/kosmos30/file/pictures_assembly_process/Reducer/DSC_0249.JPG>`__

**Installation des parois du réducteur :**

-  Rassembler le réducteur, 19 vis M3*14mm 19 écrous M3 ainsi que les 4
   plaques C1 et C2.

`View DSC_0260.JPG @
Wikifactory <https://wikifactory.com/@konkarlab/kosmos30/file/pictures_assembly_process/Reducer/DSC_0260.JPG>`__

-  Positionner 4 vis M3*14mm dans chaque trou des deux plaques C2.
   Engager pour chaque vis un écrou sur chacune des vis sans la serrer.
-  Positionner Les 17 autres vis et écrous de la même manière sur le
   tour complet du réducteur (les deux plaques en PMMA parallèles).
   Positionner les écrous vers l’intérieur du réducteur.

`View DSC_0251.JPG @
Wikifactory <https://wikifactory.com/@konkarlab/kosmos30/file/pictures_assembly_process/Reducer/DSC_0251.JPG>`__

-  Installer les plaques C2 sur les deux côtés les plus court du
   réducteur. Serrer les vis une à une en veillant à ce que les écrous
   viennent bloquer la plaque. Attention à serrer à tâton pour éviter de
   fendre le PMMA.

`View DSC_0265.JPG @
Wikifactory <https://wikifactory.com/@konkarlab/kosmos30/file/pictures_assembly_process/Reducer/DSC_0265.JPG>`__

-  Installer Les plaques C1 sur les deux côtés longs du réducteur. Comme
   à l’étape précédente, veiller à ce que les écrous viennent bloquer la
   plaque. Attention à serrer à tâtons pour éviter de fendre le PMMA.

`View DSC_0269.JPG @
Wikifactory <https://wikifactory.com/@konkarlab/kosmos30/file/pictures_assembly_process/Reducer/DSC_0269.JPG>`__

Ajout du mode MICADO
--------------------

Le principe du mode MICADO est de pouvoir laisser le KOSMOS en position
pendant plusieurs jours. L’objectif n’est pas de le faire tourner
pendant toute la durée d’immersion comme pour le mode STAVIRO. Le but du
mode MICADO est d’activer le système sur des horaires bien précis rentré
par l’utilisateur auparavant et de faire tourner le KOSMOS pendant une
durée rentrée au préalable par l’utilisateur ( en général 15 minutes ).
Ce système permet de faire plusieurs prélèvements de vidéos au même
endroit sur des plages horaires précises sans à avoir à remonter le
KOSMOS entre chaque prise.

Pour réaliser ceci, nous utilisons une carte Adafruit Trinket 1501
reliée à un module RTC. Celle-ci permettra de contrôler l’alimentation
du système grâce à un relais. Elle allumera la carte RaspBerry sur les
plages horaires rentréesconso par l’utilisateur. Nous sommes obligé
d’utiliser une carte auxiliaire car le mode veille de la carte Raspberry
consomme énormément. Le gros avantage de cette carte est sa très faible
consommation.

Un autre avantage de cette carte est sa toute petite taille : elle
mesure 31mm x 15.5mm x 5mm. Elle dispose des ports I2C nécessaires pout
être connectée au module RTC et d’une sortie GPIO permettant de
contrôler le relais.



   image

Pour réaliser le mode MICADO il faut tout simplement que l’alimentation
de la RaspBerry ne soit pas directement reliée à la batterie mais au
relais qui lui est relié à la batterie. Grâce à l’ajout d’un domino nous
pouvons passer du mode MICADO au mode STAVIRO en changeant seulement de
câble.

Voici le montage entre le module RTC, l’Adafruit et le relais :

Le montage est fixé sur une plaque imprimée en 3D ( vous pouvez la
retrouver dans “Files -> KOSMOS_2-0_beta1 -> Montage MICADO” ). Celle-ci
est fixé par dessus la RaspBerry grâce à du colson et les composants
sont fixés grâce à des vis ou des goupilles. La complexité est de tout
faire rentrer dans le tube étanche, c’est pour cela qu’on accorde
beaucoup d’importance à la disposition des composants.

Pour clarifier ce montage, voici le schéma correspondant :



   image

La carte Adafruit est assez particulière à programmer. Elle n’est pas
100% compatible avec l’IDE Arduino : Il faut donc opérer quelques
astuces. Nous avons rencontré quelques difficultés pour la programmer ;
programmer avec Arduino, lancer le téléversement. Vous retrouverez un
TUTO très détaillé de ces étapes dans “Files -> KOSMOS_2-0_beta1 ->
Montage MICADO” du Wiki.

Vous y trouverez aussi le code Arduino expliqué permettant de programmer
la carte Adafruit sur des plages horaires précises. Ces horaires devant
être rentrer par l’utilisateur.

Une fois ces horaires rentrer, l’utilsateur n’a qu’à activer
l’alimentation du KOSMOS et le poser au fond. Le KOSMOS va ainsi filmer
pendant une période définie par l’utilisateur aux mêmes heures pendant
quelques jours. Cela permettra d’avoir une analyse plus étendue d’un
même endroit.
