earnaud/KOSMOS_test/docs/_static/images/inte3D_legende.png

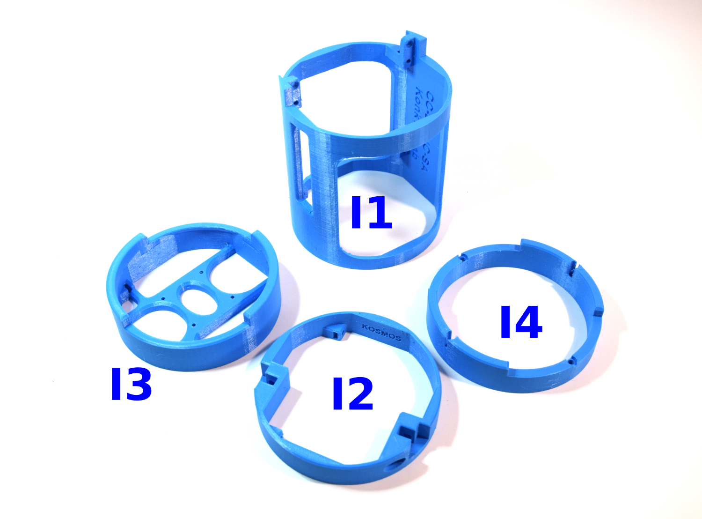
docs/_static/images/inte3D_legende.png
