earnaud/KOSMOS_test/docs/KOSMOS_3-0_beta1/3Dmodels_KOSMOS_3-0/Outside_KOSMOS_V3-0/R3_KOSMOS_V3-0.stl

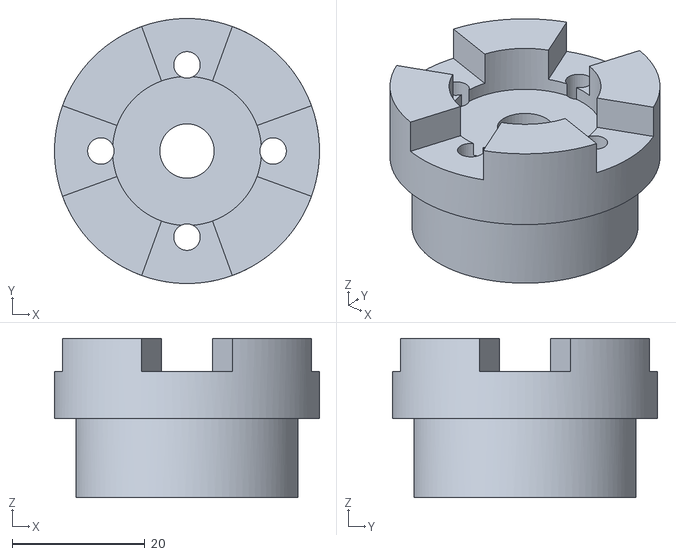
[picture p5: CAD file, 2022-06-28]
docs/KOSMOS_3-0_beta1/3Dmodels_KOSMOS_3-0/Outside_KOSMOS_V3-0/R3_KOSMOS_V3-0.stl
40.0 x 40.0 x 24.0
