earnaud/KOSMOS_test/docs/KOSMOS_3-0_beta1/Montage MICADO/Piece_MIKADO.STL

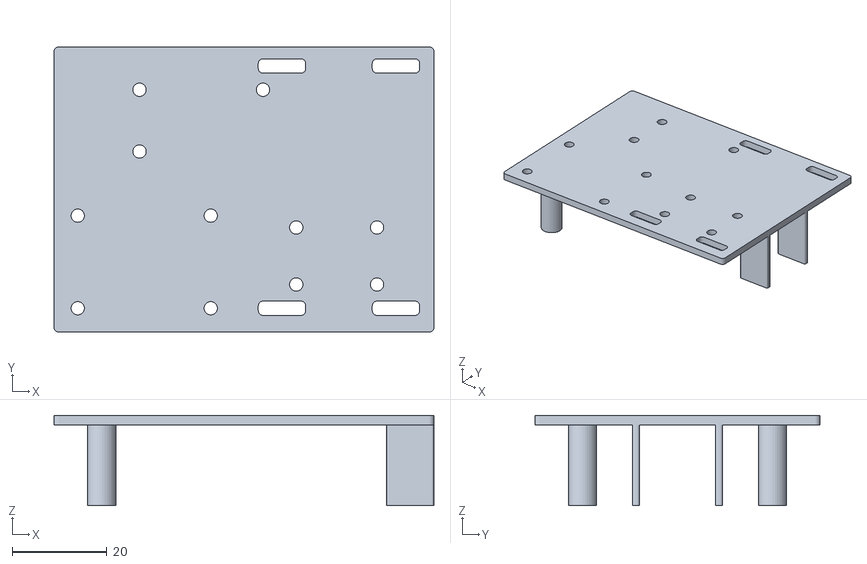
[picture p6: CAD file, 2022-06-28]
docs/KOSMOS_3-0_beta1/Montage MICADO/Piece_MIKADO.STL
80.0 x 60.0 x 19.0
