earnaud/KOSMOS_test/docs/KOSMOS_3-0_beta1/3Dmodels_KOSMOS_3-0/Inside_tube_KOSMOS_V3-0/I4_KOSMOS_V3-0.stl

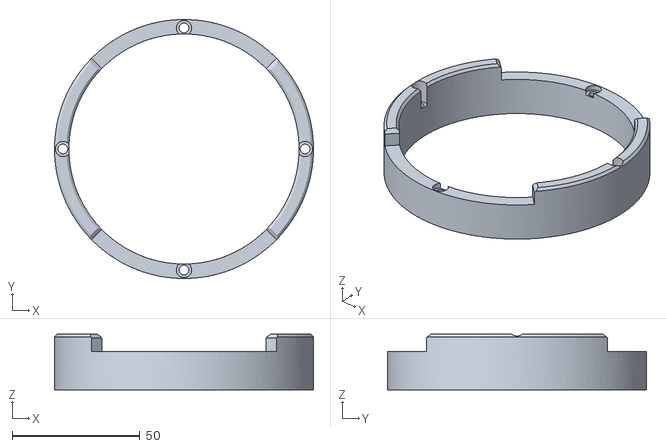
[picture p7: CAD file, 2022-06-28]
docs/KOSMOS_3-0_beta1/3Dmodels_KOSMOS_3-0/Inside_tube_KOSMOS_V3-0/I4_KOSMOS_V3-0.stl
101.2 x 101.2 x 21.7
