earnaud/KOSMOS_test/docs/KOSMOS_3-0_beta1/3Dmodels_KOSMOS_3-0/Outside_KOSMOS_V3-0/R5_KOSMOS_V3-0.stl

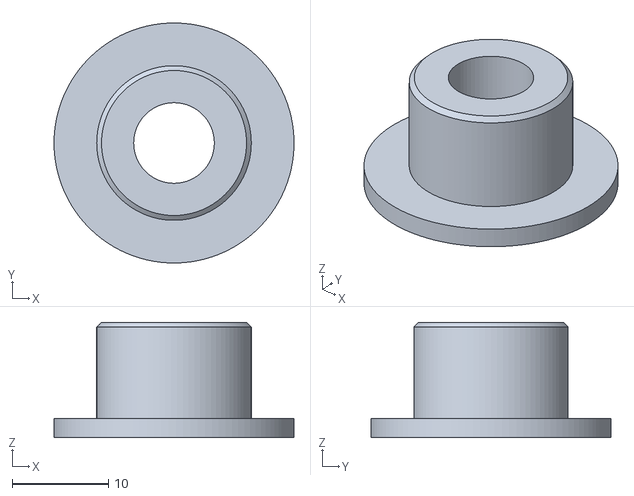
[picture p10: CAD file, 2022-06-28]
docs/KOSMOS_3-0_beta1/3Dmodels_KOSMOS_3-0/Outside_KOSMOS_V3-0/R5_KOSMOS_V3-0.stl
25.0 x 25.0 x 12.0
