earnaud/KOSMOS_test/docs/KOSMOS_3-0_beta1/3Dmodels_KOSMOS_3-0/Outside_KOSMOS_V3-0/R1_Kosmos_V3-0.stl

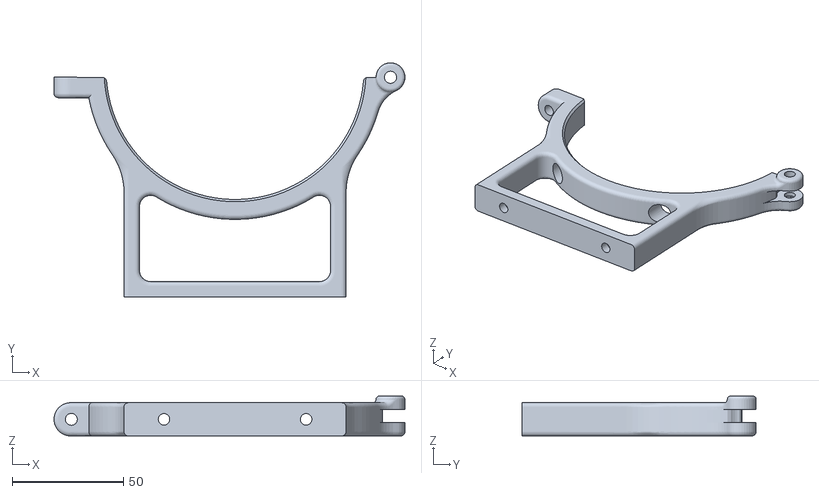
[picture p12: CAD file, 2022-06-28]
docs/KOSMOS_3-0_beta1/3Dmodels_KOSMOS_3-0/Outside_KOSMOS_V3-0/R1_Kosmos_V3-0.stl
158.0 x 105.5 x 18.0
