earnaud/KOSMOS_test/docs/KOSMOS_3-0_beta1/3Dmodels_KOSMOS_3-0/Outside_KOSMOS_V3-0/R4_KOSMOS_V3-0.stl

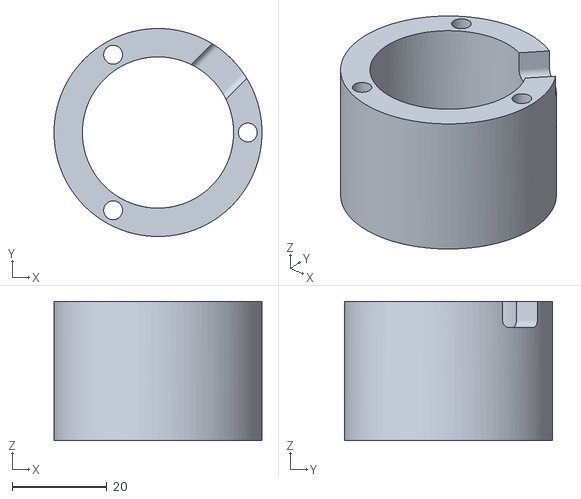
[picture p13: CAD file, 2022-06-28]
docs/KOSMOS_3-0_beta1/3Dmodels_KOSMOS_3-0/Outside_KOSMOS_V3-0/R4_KOSMOS_V3-0.stl
44.0 x 44.0 x 29.5
