earnaud/KOSMOS_test/docs/KOSMOS_3-0_beta1/3Dmodels_KOSMOS_3-0/Outside_KOSMOS_V3-0/R1.2_KOSMOS_V3-0.stl

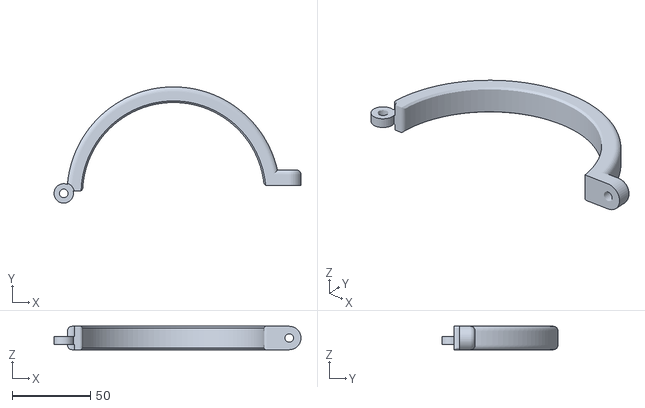
[picture p14: CAD file, 2022-06-28]
docs/KOSMOS_3-0_beta1/3Dmodels_KOSMOS_3-0/Outside_KOSMOS_V3-0/R1.2_KOSMOS_V3-0.stl
157.6 x 74.2 x 15.0
