earnaud/KOSMOS_test/docs/pictures_assembly_process/Camera_case/DSC_0233.JPG

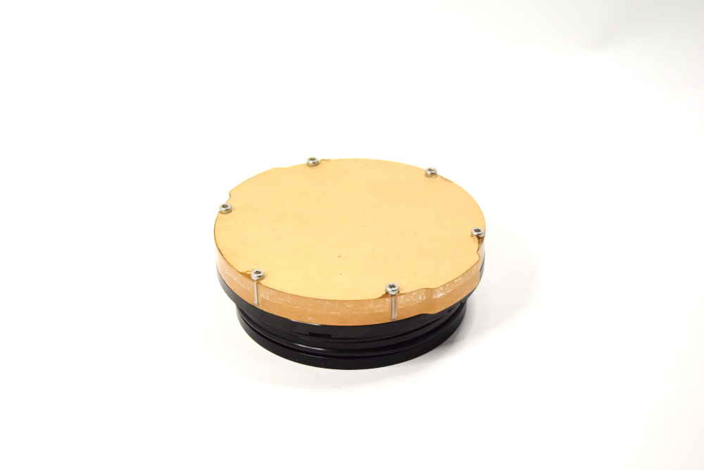
docs/pictures_assembly_process/Camera_case/DSC_0233.JPG
