earnaud/KOSMOS_test/docs/pictures_assembly_process/Camera_case/DSC_0235.JPG

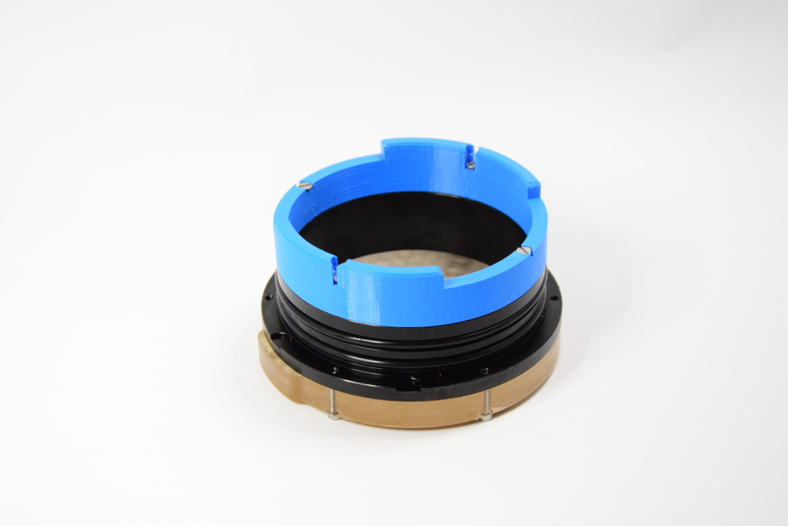
docs/pictures_assembly_process/Camera_case/DSC_0235.JPG
