earnaud/KOSMOS_test/docs/pictures_assembly_process/Camera_case/DSC_0238.JPG

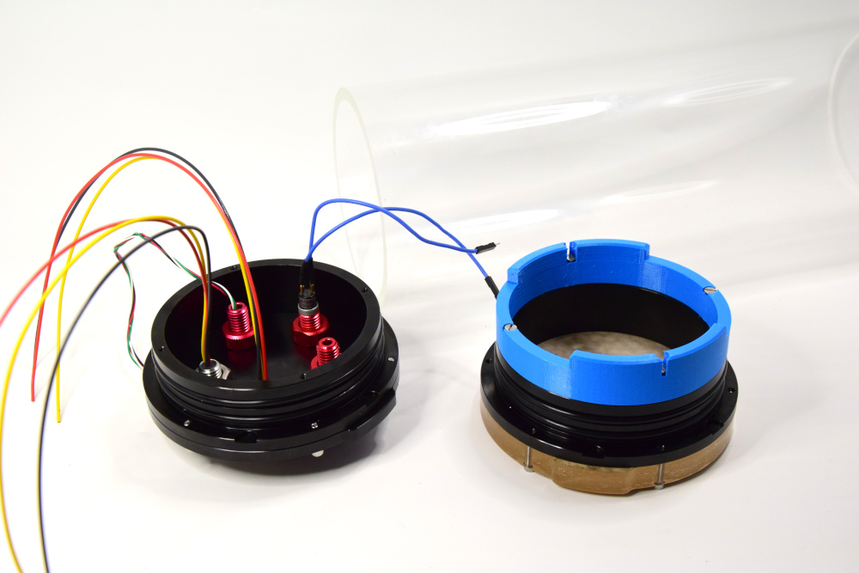
docs/pictures_assembly_process/Camera_case/DSC_0238.JPG
