earnaud/KOSMOS_test/docs/pictures_assembly_process/Captions/legende_decoupePMMAA3.png

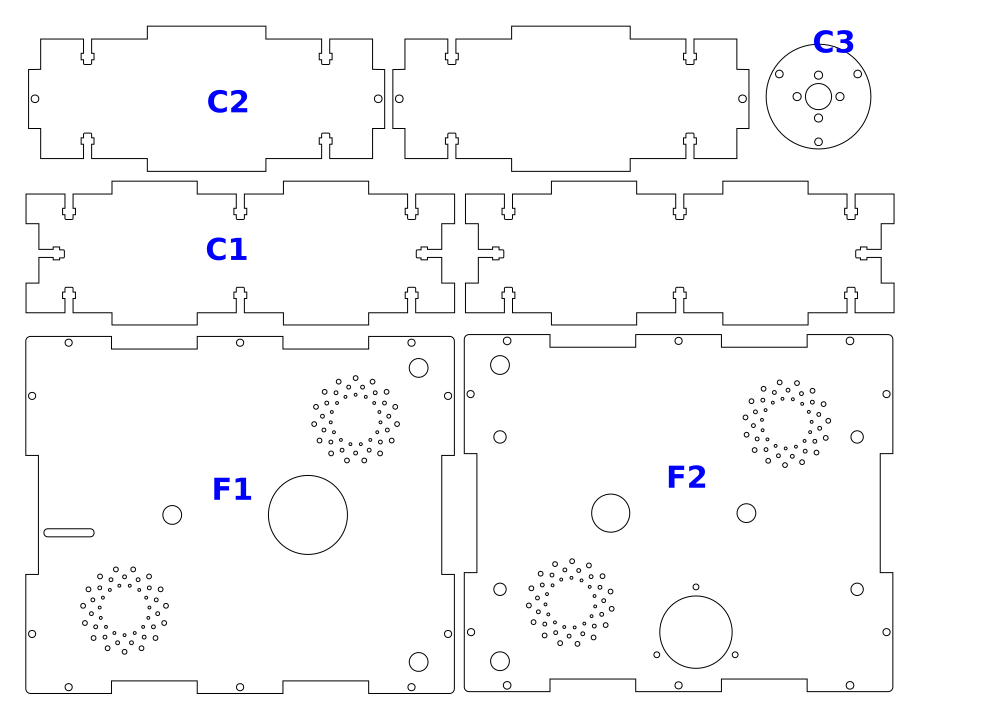
docs/pictures_assembly_process/Captions/legende_decoupePMMAA3.png
