earnaud/KOSMOS_test/docs/pictures_assembly_process/Captions/legende_decoupePOMA4.png

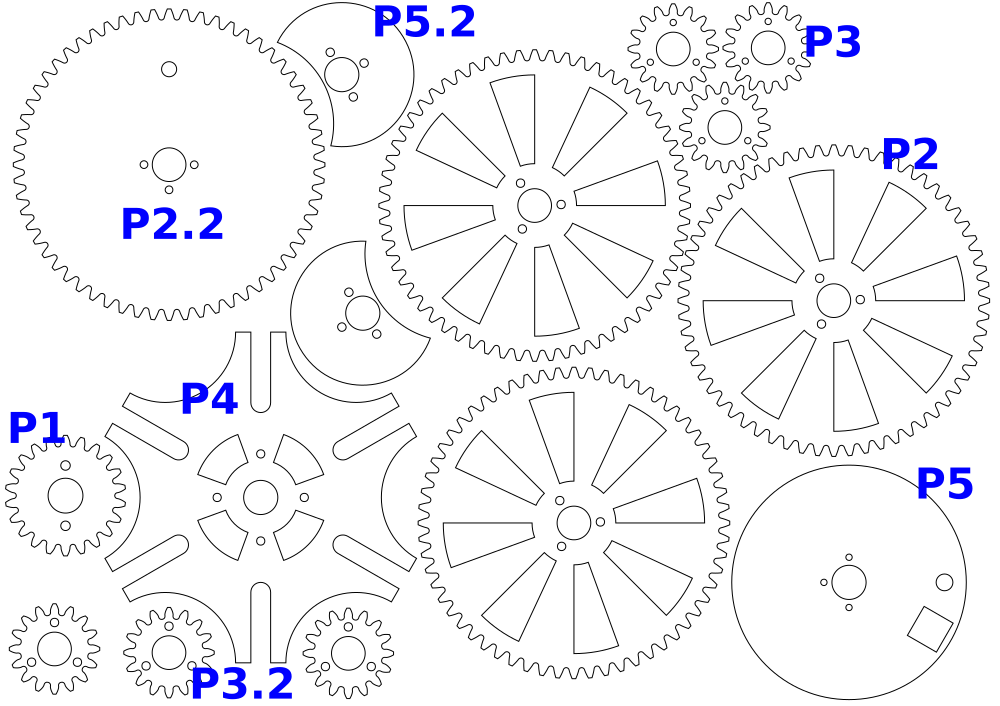
docs/pictures_assembly_process/Captions/legende_decoupePOMA4.png
