earnaud/KOSMOS_test/docs/pictures_assembly_process/Captions/legende_str_int_PMMA_5mm_A5.png

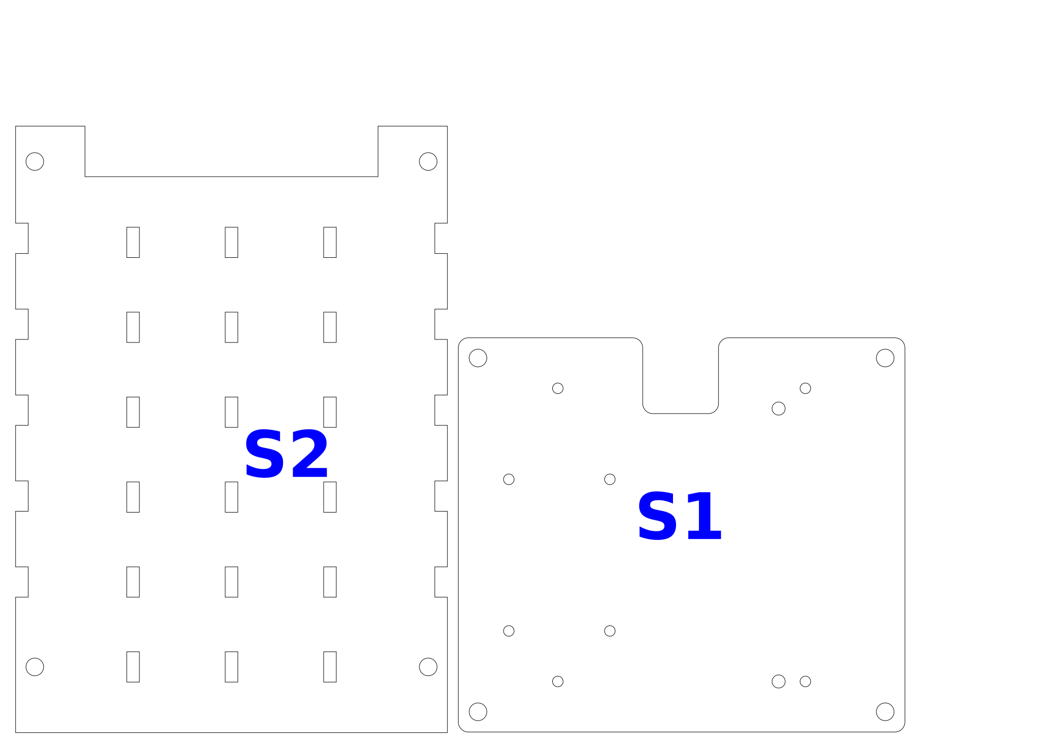
docs/pictures_assembly_process/Captions/legende_str_int_PMMA_5mm_A5.png
