earnaud/KOSMOS_test/docs/pictures_assembly_process/Captions/PHOTO_20220317_182010_petit.png

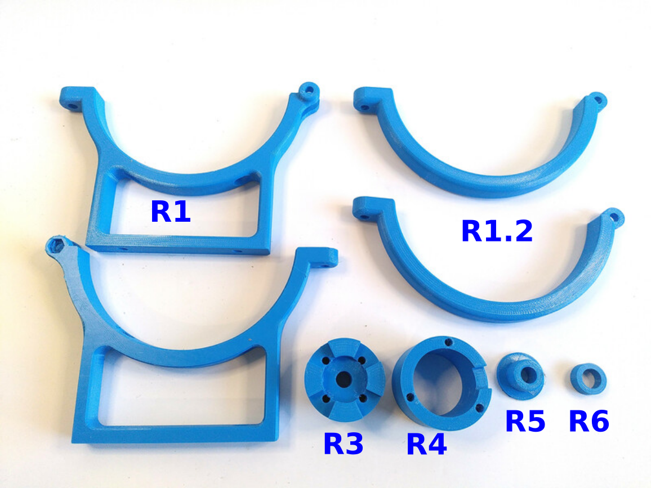
docs/pictures_assembly_process/Captions/PHOTO_20220317_182010_petit.png
