earnaud/KOSMOS_test/docs/pictures_assembly_process/Reducer/DSC_0006_petit-3.jpg

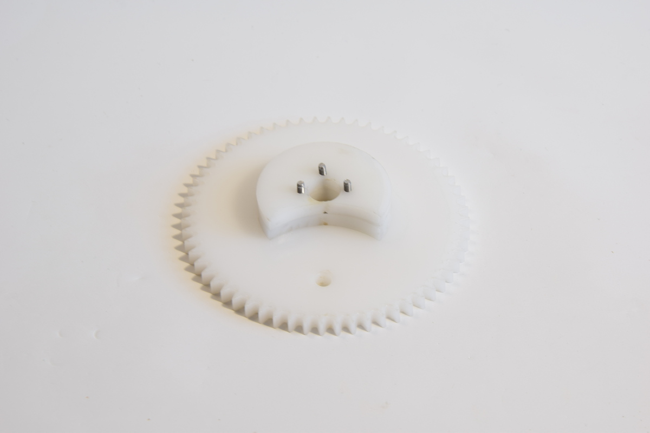
docs/pictures_assembly_process/Reducer/DSC_0006_petit-3.jpg
