earnaud/KOSMOS_test/docs/pictures_assembly_process/Reducer/DSC_0006_petit-b.jpg

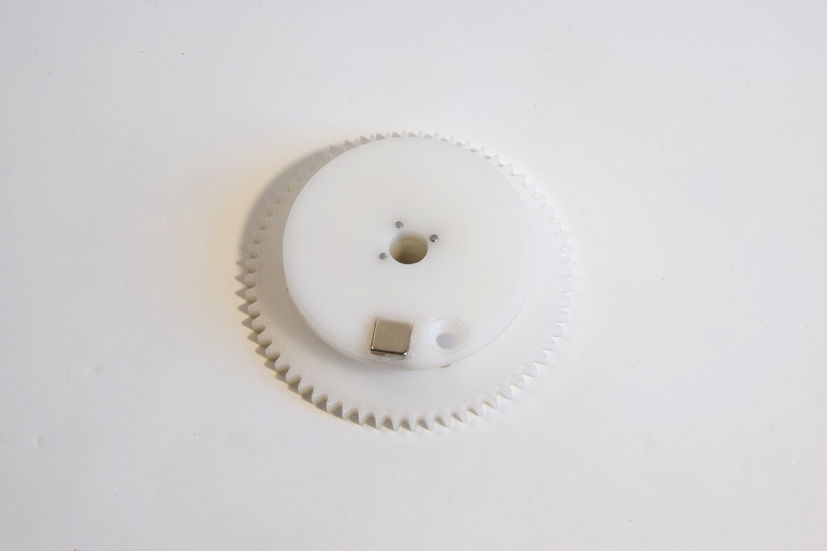
docs/pictures_assembly_process/Reducer/DSC_0006_petit-b.jpg
