earnaud/KOSMOS_test/docs/pictures_assembly_process/Reducer/DSC_0017_petit.jpg

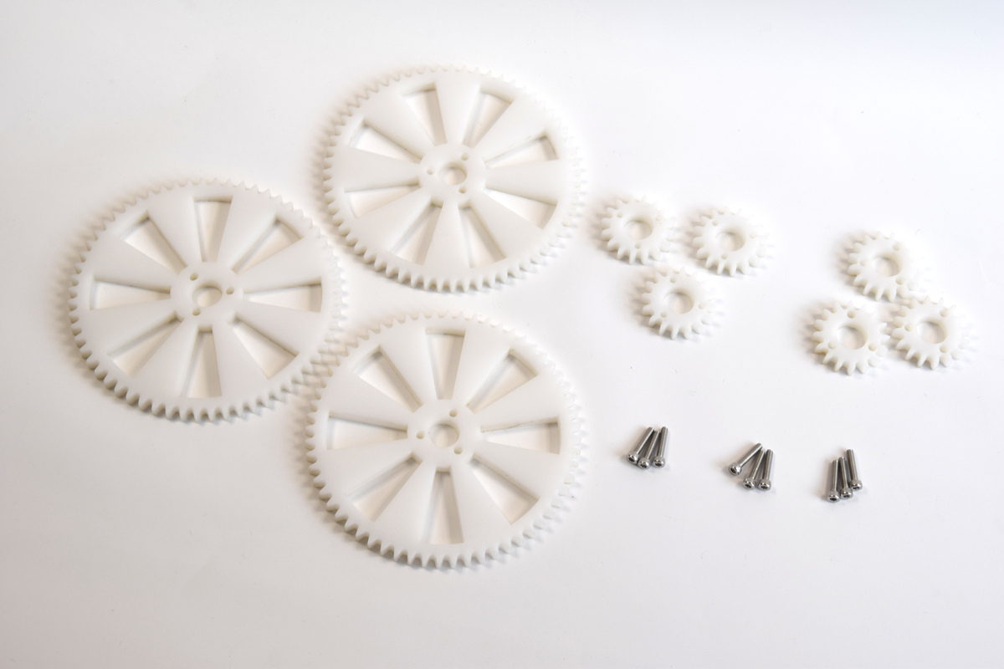
docs/pictures_assembly_process/Reducer/DSC_0017_petit.jpg
