earnaud/KOSMOS_test/docs/pictures_assembly_process/Reducer/DSC_0023_petit-b.jpg

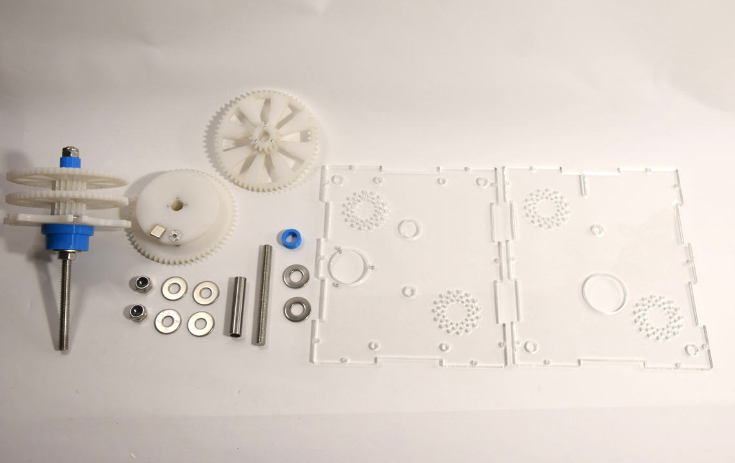
docs/pictures_assembly_process/Reducer/DSC_0023_petit-b.jpg
