earnaud/KOSMOS_test/docs/pictures_assembly_process/Reducer/DSC_0028_petit-b.jpg

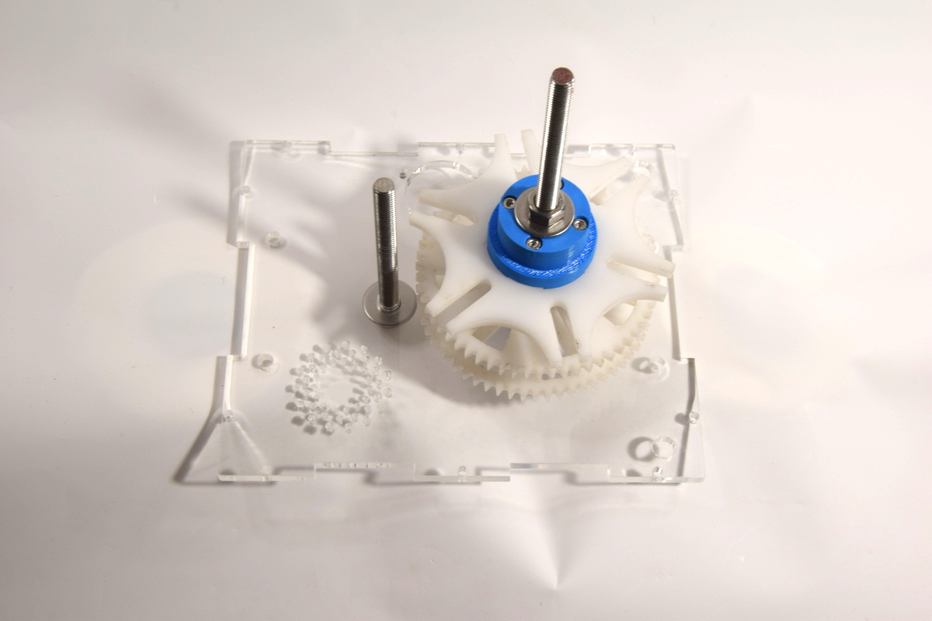
docs/pictures_assembly_process/Reducer/DSC_0028_petit-b.jpg
