earnaud/KOSMOS_test/docs/pictures_assembly_process/Reducer/DSC_0036_petit_b.jpg

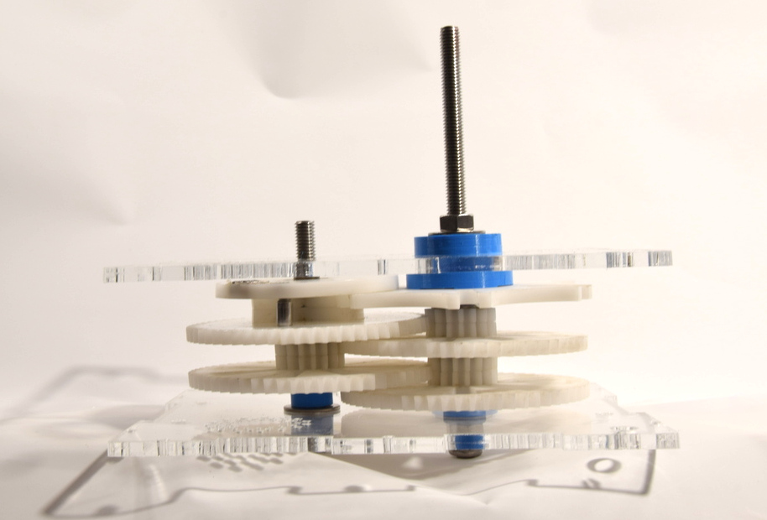
docs/pictures_assembly_process/Reducer/DSC_0036_petit_b.jpg
