earnaud/KOSMOS_test/docs/pictures_assembly_process/Reducer/DSC_0049.JPG

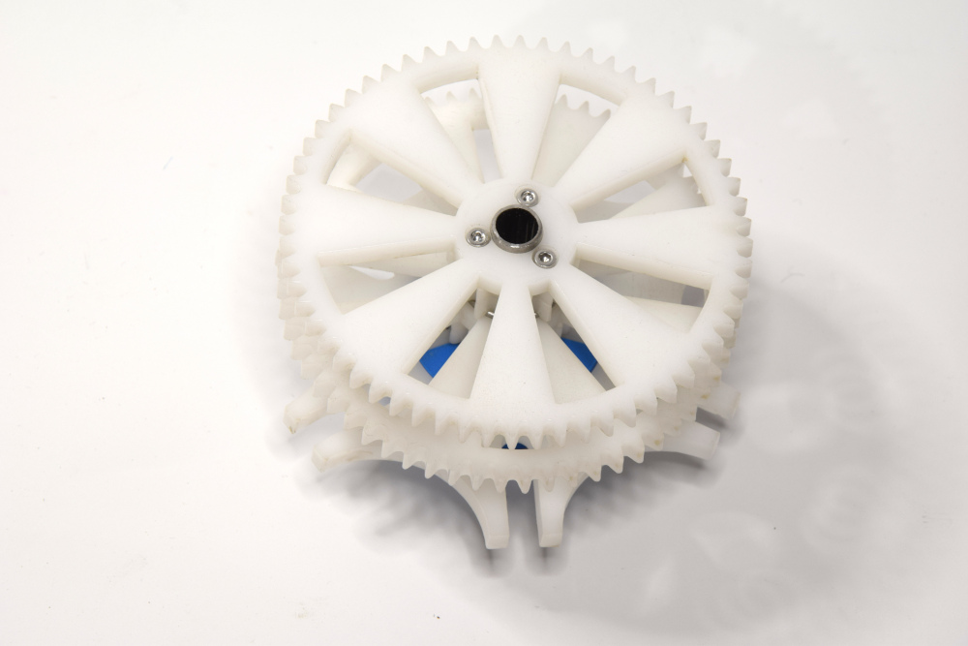
docs/pictures_assembly_process/Reducer/DSC_0049.JPG
