earnaud/KOSMOS_test/docs/pictures_assembly_process/Reducer/DSC_0050_petit.jpg

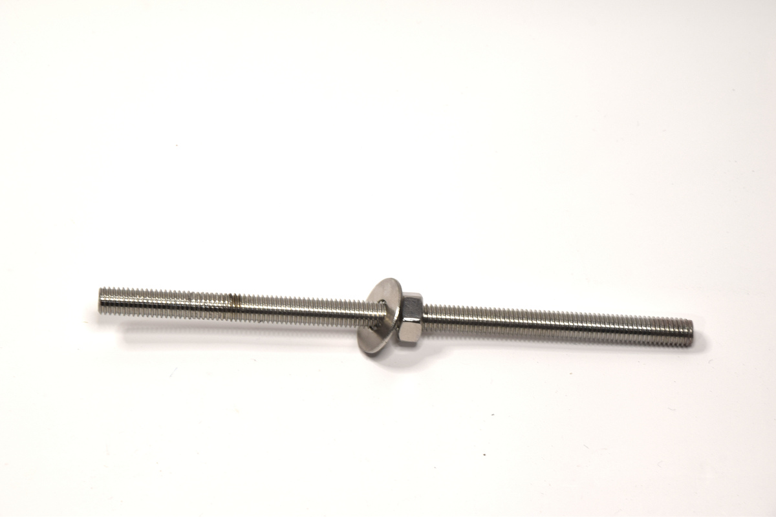
docs/pictures_assembly_process/Reducer/DSC_0050_petit.jpg
