earnaud/KOSMOS_test/docs/pictures_assembly_process/Reducer/DSC_0051.JPG

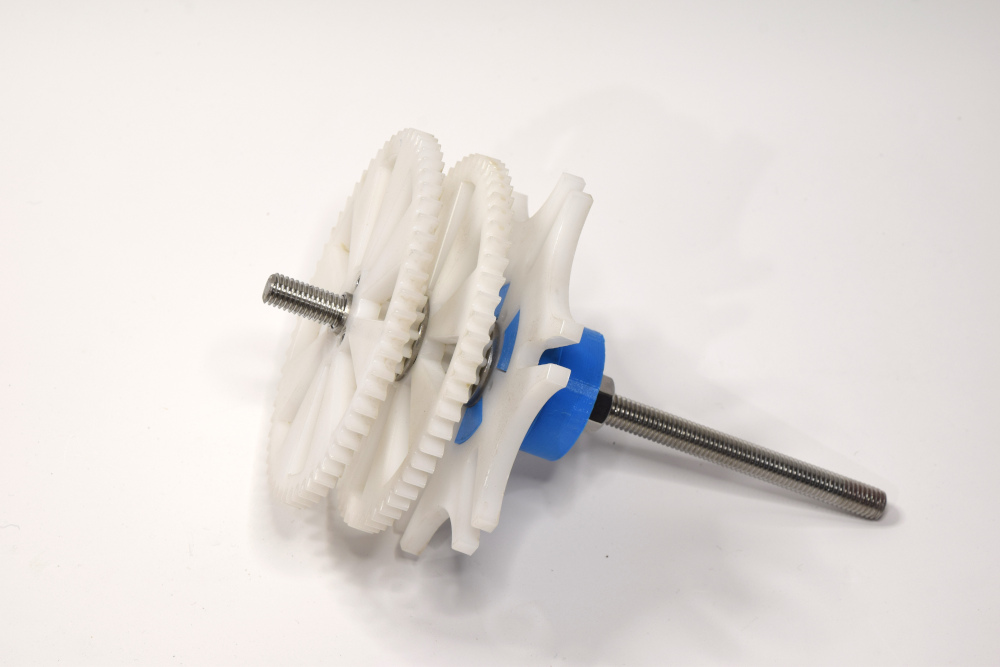
docs/pictures_assembly_process/Reducer/DSC_0051.JPG
