earnaud/KOSMOS_test/docs/pictures_assembly_process/Reducer/DSC_0051_petit_b.jpg

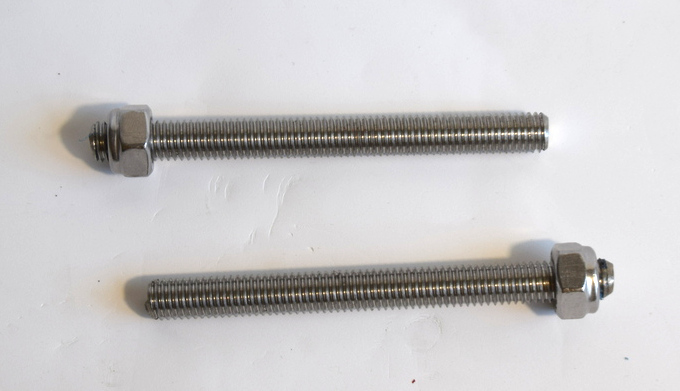
docs/pictures_assembly_process/Reducer/DSC_0051_petit_b.jpg
