earnaud/KOSMOS_test/docs/pictures_assembly_process/Reducer/DSC_0057.JPG

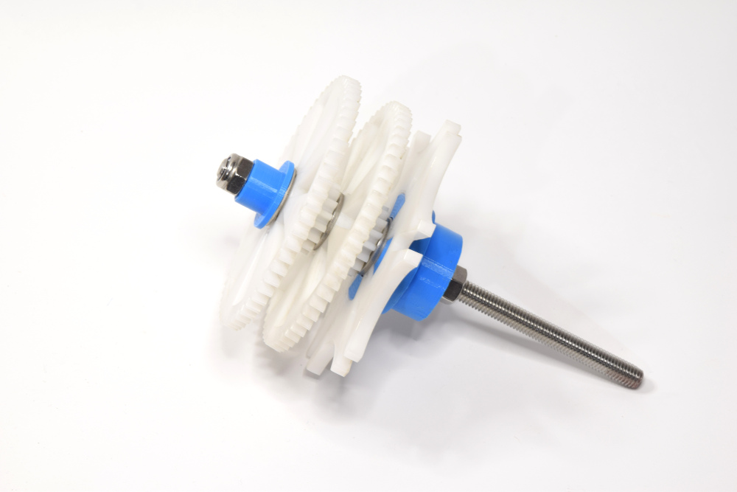
docs/pictures_assembly_process/Reducer/DSC_0057.JPG
