earnaud/KOSMOS_test/docs/pictures_assembly_process/Reducer/DSC_0084_petit.jpg

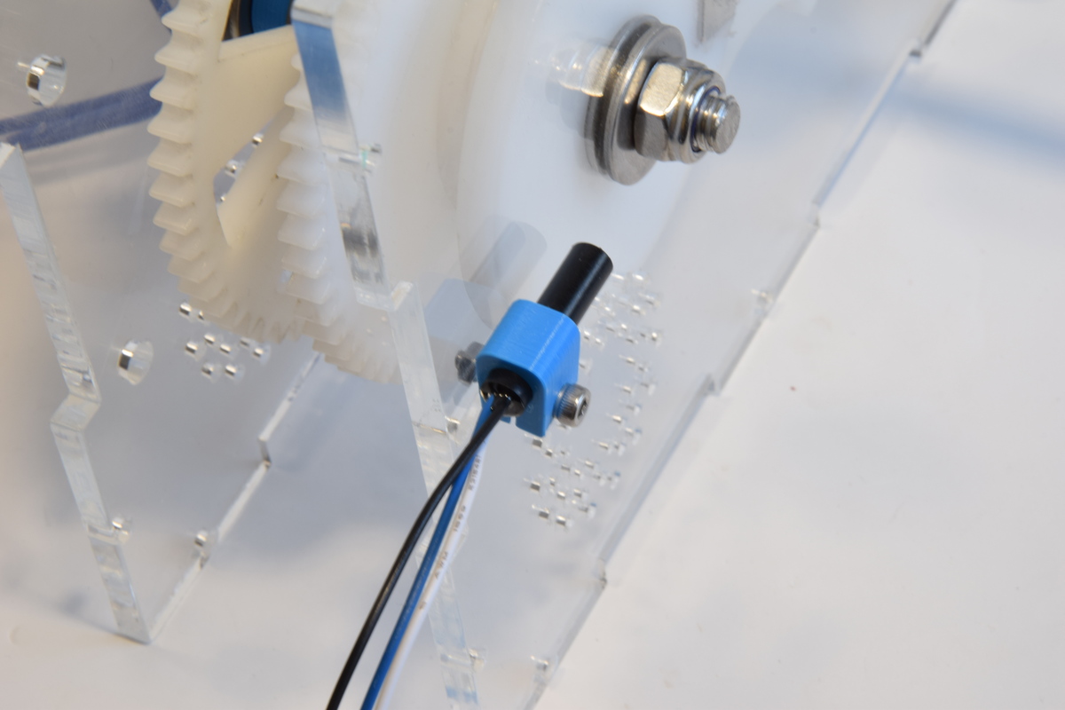
docs/pictures_assembly_process/Reducer/DSC_0084_petit.jpg
