earnaud/KOSMOS_test/docs/pictures_assembly_process/Reducer/DSC_0241_petit.JPG

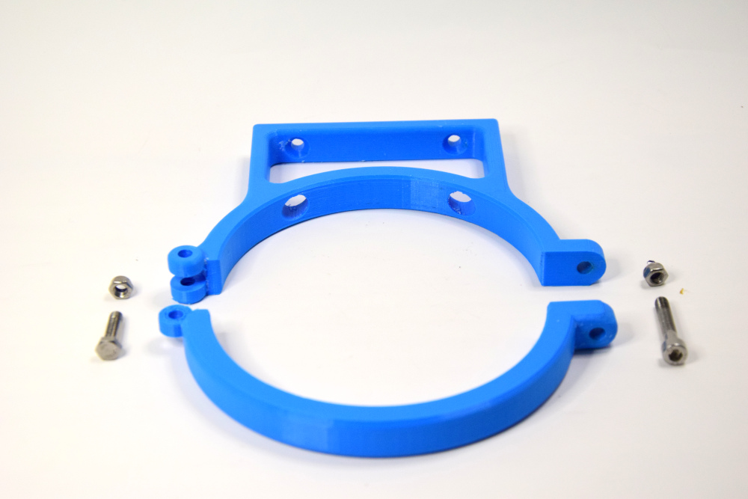
docs/pictures_assembly_process/Reducer/DSC_0241_petit.JPG
